LieBtrau/simon-says/(list of files, drawings)

Other design files:
Hardware/BRD150118.pcbdoc
Hardware/SimonSays.PrjPcb
Hardware/SimonSays.SchDoc
