LieBtrau/simon-says/src/main.h

#ifndef MAIN
#define MAIN
#ifdef __cplusplus
extern "C" {    //define avr-gcc compiled headers & sources here
#endif

void loop();
void setup();
#ifdef __cplusplus
} // extern "C"
#endif

#endif // MAIN
