LieBtrau/simon-says/(commit log)

2015-01-25 Setting up build environment + working example of "rotating" LEDs
2015-01-31 Replaced own simple debugSerial port by the one provided by the attiny library. It runs on 9600 instead of 1200baud.
    [qtouchadc.cpp, qtouchadc.h, test.cpp]
2015-02-01 Working capacitive touch on one pin.
2015-02-02 Implementing limit to check whether a button is pushed or not.
2015-02-02 Demo using all hardware: -reading capacitive buttons -lighting LEDs -playing sound
2015-02-04 Tone generating changed to own implementation with fast PWM. The sound is much clearer.
2015-02-04 Switching back to original LED configuration as assembled on the PCB.
2015-02-16 Recalibrating capacitive buttons needed for running battery only, without wires.
2015-02-18 Power saving mode implemented.
2015-03-07 Let's consider this the final version. It works well on R1 PCB. If detection is not good, place your finger on the DB9 connection to hold the PCB on the table. Use your other hand to play the game.
2015-03-18 Adding hardware info
    [BRD150118.pcbdoc, SimonSays.PrjPcb, SimonSays.SchDoc]
2015-03-18 Updated with PCB info
2015-03-31 Adding links to 3D images of PCB assembly
